dlewis80/DeeplyCastNet/README.md

# DeeplyCastNet
Senior Design Project to make an Underwater Acoustic Modem for swarm robotics

Check out our [wiki](https://github.com/dlewis80/DeeplyCastNet/wiki) for more information!
