dlewis80/DeeplyCastNet/hardware/DeeplyCastNet_BOM.xlsm

Sheet: Instructions
Basic Instructions:
Copy this file to your own computer before filling out forms.
Please keep track of your ticket ID assigned after submission.
***When ordering, submit only ONE ticket/form per vendor.***
 | ONLY fill out ONE tab per ticket.
*Send/Store Acknowledgement upon receipt of order by replying to your ticket email or sending information to megan.horne@gtri.gatech.edu
o Inspect the received items for conformance to purchase requirements and note issues if any
o If you experience issues with procured items or supplier service, such as receipt of damaged or incorrect items, please notify ELSYS Procurement and complete a Nonconforming Procured Item Record.
§ If you experience issues with procured items or supplier service, such as receipt of damaged or incorrect items,
please notify ELSYS Procurement and complete a Nonconforming Procured Item Record under Important Links.
§ After completing the record, please keep a copy in your project files (updating it as needed) and send a copy to QA at ELSYS-ISO-HELP@gtri.gatech.edu.
o Send a record of receipt. Examples of receipt records include:
§ Packing slips
§ Copy of a packing slip with notations
§ E-mail stating confirmation of purchase
§ E-mail stating approval for payment of items
o Store the receipt record in the project files.
Specifics:
-For orders under $10k go to the appropriate tab based on total cost:
 | Orders over $2,499 (including shipping fees) cannot be processed with a vendor who is not in Workday.
 | Orders under $10k can be placed based at your discretion so long as you do market research.
 | A formal quote from the vendor needs to be attached with the ticket.
-Sole Sources are to be used when ONLY 1 vendor can supply the goods or services. For Sole Sources, use the "Sole Source" tab.
 | Orders $10k and over must be sole sourced, soft bid, or open bid.
 | Orders $25k and over must be sole sourced or open bid.
 | A formal quote from the vendor needs to be attached with the ticket.
 | If other vendors can provide the SAME (technically acceptable) item, it is NOT a Sole Source
 | Sole Source orders $25k to under $250k will be posted on the GPR for 5 business days to be challenged.
 | At and above $250k is 15 calendar days.
-Soft Bid is an order between $10k and $25k in which you must obtain a minimum of 3 quotes for specific items or services.
 | Orders $10k and over must be sole sourced, soft bid, or open bid.
 | The quote with the lowest cost (technically acceptable) will be who you order from.
-Open Bid is a full competitive action that must be posted to the Georgia Public Registry for between 3 and 30 calendar days depending on price.
 | Orders $10k and over must be sole sourced, soft bid, or open bid.
 | Orders $25k and over must be sole sourced or open bid.
 | Open Bids can be simple or complicated depending on your requirements.
 | If this is your first Open Bid or if you need help phrasing your requirements, you can contact me or one of our contract officers (Belinda Randolph 404-385 0585)
-Punchouts are pre-established contracts that have no price ceiling.
 | No quote is required for a punchout vendor.
 | Punchout vendors are: BioRad, Dell, Digi-Key, Eurofins, Fisher Scientific, Grainger, HP, ThermoFisher Scientific, MSC, Newark, Sigma-Aldrich, Staples, VWR International, CDW-G, America To Go, Airgas, Amazon and B&H.
 | Punchout orders do not need to have NIGP Code or price fields filled out as they are extraneous.
 | Put punchout orders on the "Under $10K" tab
-If you ever have more than 25 items for one order, submit additional forms on the same ticket. After the first form is completed, you only have to fill out the line item information on subsequent forms.
 | Note: there are two options to "reset" your form. One includes resetting line items only.
Important Links:
Spend Category
NIGP Codes (http://doas.ga.gov/state-purchasing/purchasing-tools/nigp-codes)
Consulting Form - Apex Systems
Consulting Form - Insight Global
Sole Source Form
ELSYS NonConforming Procured Item
Replacement Packing Slip
Disclaimers:
If you fail to fully complete a form, your order will be delayed.
If you fail to submit the form properly (multiple orders on one submitted ticket, missing documents such as a quote or approval), your order will be delayed.
Monetary limits include shipping costs. If you are unsure of the shipping costs, please reach out to the vendor for a shipping estimate.
The brief instructions provided in this spreadsheet are merely rudimentary guidance for completing ELSYS ALL forms and tickets. They are not final or comprehensive and are not intended to be used as or substituted for procurement guidance.
If you have any questions, please contact Megan Horne (404-407-8892)

Sheet: Under $10k
$0.01 - $9,999.99 (1 Vendor Per Ticket) *Send acknowledgement upon receipt of order (see Instructions tab for details) |  |  |  |  |  | Version 6.3
Requestor | Name: | Mick West | Division | TEN | Requestor Comments:
 | Email: | mick.west@gtri.gatech.edu
 | Number (7-1234): | 7-8638
Accounting | M&S Sub-budget (D1234.05.06.07.0008): | W1246.01.00.00.00005
 | Labor Sub-budget (D1234.05.06.07.0008): | W1246.01.00.00.00005
 | Spend Category (123456): | W1246.01.00.00.00005
Vendor | Vendor Name: | Digikey
 | Vendor Website: | digikey.com
Additional Info
 | Please provide a detailed business purpose (including how it will be used on the project). | Material to help with VIP team develop underwater microfloat vehicle.
 | Are these products going to be used exclusively on this project (W1246) as property of the sponsor unless sponsor has authorized us to retain them?
 | Who will be the end user (retain the title) of item(s)/software/services being purchased for ?
 | Is this purchase for hardware, networking, telecom, audio visual or 'X' as a service?
 | Is this purchase an addition to existing inventoried equipment? |  | IF YES: Provide tag # of inventoried equiptment :
 | If this requisition is for an asset, does it require special disposal?
 | Are you currently aware of any additional orders that you intend to place in the forseeable future from this vendor? | No
 | If "Yes", explain and please be specific:
Shipping | Building (list): | 430N 10th ST
 | Room #: | Bay 9
 | Requested shipping method (list):
 | Ship complete or as available (list)(*Note: "complete" - company will hold entire order until backorders are available so this may cause delay*): | As Available
 | Need by date (*Please note if you put a need by date, your shipping method may be updated so that items arrive by this date*):
Line Item | Supplier Part # (not Manufacturer #) | Item Description | Quantity | Unit Price | NIGP Code | OPTIONAL: Link to item at vendor website. Link may be item number/description as hyperlink, or http web address. Supplying links is recommended for Pcard orders to Amazon, eBay and other vendors in addition to supplier and item info.
1 | 2N5401YBUOS-ND | PNP Transistor | 10 | $0.26 | 204--16 | https://www.digikey.com/product-detail/en/on-semiconductor/2N5401YBU/2N5401YBUOS-ND/975298
2 | IR2110PBF-ND | Gate Driver | 5 | $2.92 | 204--16 | https://www.digikey.com/product-detail/en/infineon-technologies/IR2110PBF/IR2110PBF-ND/811566
3 | 296-47192-ND | Linear Regulator | 6 | $1.54 | 204--16 | https://www.digikey.com/product-detail/en/texas-instruments/LM7805CT-NOPB/296-47192-ND/3901929
4 | 296-1845-5-ND | Dual Comparator | 4 | $1.17 |  | https://www.digikey.com/product-detail/en/texas-instruments/TLC372CP/296-1845-5-ND/277490
5 | LMC555CN/NOPB-ND | Timer | 6 | $1.34 |  | https://www.digikey.com/product-detail/en/texas-instruments/LMC555CN-NOPB/LMC555CN-NOPB-ND/32623
6 | IRF540NLPBF-ND | N-Channel MOSFET | 10 | $1.42 |  | https://www.digikey.com/product-detail/en/infineon-technologies/IRF540NLPBF/IRF540NLPBF-ND/812049
7 | PPC1.0KW-2CT-ND | 2W Resistor | 10 | $0.45 |  | https://www.digikey.com/product-detail/en/vishay-bc-components/PR02000201001JR500/PPC1.0KW-2CT-ND/597336
8 | 1740-1198-ND | NPN Transistor | 10 | $0.53 |  | https://www.digikey.com/product-detail/en/ween-semiconductors/PHE13005127/1740-1198-ND/1157518
9 | OP2177CRMZ-ND | Low-Noise Op Amp | 4 | $5.01 |  | https://www.digikey.com/product-detail/en/analog-devices-inc/OP2177CRMZ/OP2177CRMZ-ND/10238174
10 | 296-10230-5-ND | Filter | 6 | $3.89 |  | https://www.digikey.com/product-detail/en/texas-instruments/TLC04ID/296-10230-5-ND/380466
11 | 296-39653-ND | Microcontroller Dev Board | 3 | $20.76 |  | https://www.digikey.com/product-detail/en/texas-instruments/MSP-EXP432P401R/296-39653-ND/5170609
12 | 255-1228-1-ND | Solid State Relay | 3 | $4.04 |  | https://www.digikey.com/product-detail/en/panasonic-electric-works/TQ2SA-3V-Z/255-1228-1-ND/5767573
13 | AD5627RBRMZ-1REEL7CT-ND | DAC | 3 | $6.91 |  | https://www.digikey.com/product-detail/en/analog-devices-inc/AD5627RBRMZ-1REEL7/AD5627RBRMZ-1REEL7CT-ND/4908940
14
15
16
17
18
19
20
21
22
23
24
25
 |  | Total before shipping |  | $201.67

Sheet: Soft Bid
Soft Bid: $10,000 - $24,999.99 (1 Vendor Per Ticket) *Send acknowledgement upon receipt of order (see Instructions tab for details) |  |  |  |  |  | Version 6.3
Requestor | Name: |  | Division |  | Requestor Comments:
 | Email:
 | Number (7-1234):
Accounting | M&S Sub-budget (D1234.05.06.07.0008):
 | Labor Sub-budget (D1234.05.06.07.0008):
 | Spend Category (123456):
Vendor | Winning (lowest bidder) Vendor's Name:
Additional Info
 | Please provide a business purpose. A sentence or two will generally suffice.
 | Are these products going to be used exclusively on this project () as property of the sponsor unless sponsor has authorized us to retain them?
 | Who will be the end user (retain the title) of item(s)/software/services being purchased for ?
 | Is this purchase for hardware, networking, telecom, audio visual or 'X' as a service?
 | Is this purchase an addition to existing inventoried equipment? |  | IF YES: Provide tag # of inventoried equiptment :
 | If this requisition is for an asset, does it require special disposal?
 | Are you currently aware of any additional orders that you intend to place in the forseeable future from this vendor?
 | If "Yes", explain and please be specific:
 | Attach all 3+ bids/quotes
Shipping | Building (list):
 | Room #:
 | Requested shipping method (list):
 | Ship complete or as available (list)(*Note: "complete" - company will hold entire order until backorders are available so this may cause delay*):
 | Need by date (*Please note if you put a need by date, your shipping method may be updated so that items arrive by this date*):
Line Item | Supplier Part # (not Manufacturer #) | Item Description | Quantity | Unit Price | NIGP Code | OPTIONAL: Link to item at vendor website. Link may be item number/description as hyperlink, or http web address. Supplying links is recommended for Pcard orders to Amazon, eBay and other vendors in addition to supplier and item info.
1
2
3
4
5
6
7
8
9
10
11
12
13
14
15
16
17
18
19
20
21
22
23
24
25
 |  | Total before shipping |  | $0.00

Sheet: Open Bid
Open Bid: $25,000 and Over *Send acknowledgement upon receipt of order (see Instructions tab for details) |  |  |  | Version 6.3
Requestor | Name: | Division | Requestor Comments:
 | Email:
 | Number (7-1234):
Accounting | M&S Sub-budget (D1234.05.06.07.0008):
 | Labor Sub-budget (D1234.05.06.07.0008):
 | Spend Category (123456):
Vendor | Preferred Vendor List Include as much relevant contact information as you can, particularly: name/address/email/phone#
Additional Info
 | Expected delivery/start date:
 | Will you accept "or GIT accepted equal"?
 | What is the estimated amount of the purchase?
 | NIGP Code
 | Are these products going to be used exclusively on this project () as property of the sponsor unless sponsor has authorized us to retain them?
 | Who will be the end user (retain the title) of item(s)/software/services being purchased for ?
 | Is this purchase for hardware, networking, telecom, audio visual or 'X' as a service?
 | Is this purchase an addition to existing inventoried equipment? | IF YES: Provide tag # of inventoried equiptment :
 | If this requisition is for an asset, does it require special disposal?
 | Are you currently aware of any additional orders that you intend to place in the forseeable future from this vendor?
 | Attach Requirements
Shipping | Building (list):
 | Room #:
 | Requested shipping method (list):
 | Ship complete or as available (list)(*Note: "complete" - company will hold entire order until backorders are available so this may cause delay*):

Sheet: Sole Source
Sole Source: $10,000 and over (1 Vendor Per Ticket) *Send acknowledgement upon receipt of order (see Instructions tab for details) |  |  |  |  |  | Version 6.3
Requestor | Name: |  | Division |  | Requestor Comments:
 | Email:
 | Number (7-1234):
Accounting | M&S Sub-budget (D1234.05.06.07.0008):
 | Labor Sub-budget (D1234.05.06.07.0008):
 | Spend Category (123456):
 | Are these products going to be used exclusively on this project () as property of the sponsor unless sponsor has authorized us to retain them?
 | Who will be the end user (retain the title) of item(s)/software/services being purchased for ?
 | Is this purchase for hardware, networking, telecom, audio visual or 'X' as a service?
 | Is this purchase an addition to existing inventoried equipment? |  | IF YES: Provide tag # of inventoried equiptment :
 | If this requisition is for an asset, does it require special disposal?
 | Are you currently aware of any additional orders that you intend to place in the forseeable future from this vendor?
External Requirement | Fill out the below .pdf form:
 | Sole Source Form
 | Vendor Name:
Additional Info : | On the above form: *Contact Name* is the name of the Engineer who is qualified to answer technical questions about the item(s). *Requisition #* can be left blank.
Shipping | Building (list):
 | Room #:
 | Requested shipping method (list):
 | Ship complete or as available (list)(*Note: "complete" - company will hold entire order until backorders are available so this may cause delay*):
 | Need by date (*Please note if you put a need by date, your shipping method may be updated so that items arrive by this date*):
Line Item | Supplier Part # (not Manufacturer #) | Item Description | Quantity | Unit Price | NIGP Code | OPTIONAL: Link to item at vendor website. Link may be item number/description as hyperlink, or http web address. Supplying links is recommended for Pcard orders to Amazon, eBay and other vendors in addition to supplier and item info.
1
2
3
4
5
6
7
8
9
10
11
12
13
14
15
16
17
18
19
20
21
22
23
24
25
 |  | Total before shipping |  | $0.00

Sheet: Contractor
Contractor (1 Contractor Per Ticket) *Ensure that you are following updated processes with HR prior to submitting this request for a PO |  |  |  |  | Version 6.3
Requestor | Name: |  | Division | Requestor Comments:
 | Email:
 | Number (7-1234):
Accounting | Labor Sub-budget (D1234.05.06.07.0008):
 | Contractor's Manager:
 | Who is tracking their hours?
 | Will this contractor be working on sponsored SOW?
Forms | Attach Contractor's Resume
 | Attach Consulting Form
 | Attach Work Order
 | Attach FAR
 | Attach NDA
Line Item | Contractor's Name | Start Date - End Date | Total Price
1
 |  | Total | $0.00

Sheet: Database
 | Ticket # (For Pcard orders, vendor uses Ticket # as PO#) | Project Number / Account Code | Charge Number for Time | Vendor (Supplier) | Ordered: WorkDay / Email / Fax / Online / Phone / Store | Date Ordered | WorkDay RQ# / WorkDay PO# / Vendor Order#(s) / How Ship or Delivery Date / Tracking# | Invoice Amount | Division | Street/ RM/ Ext. | Ordered For | Additional Information
Under 10k |  | W1246.01.00.00.00005/W1246.01.00.00.00005 | W1246.01.00.00.00005 | Digikey |  |  | /PO- // | 201.67 | TEN | 430N 10th ST/Bay 9/7-8638 | Mick West
Soft Bid |  | / | .... | 0 |  |  | /PO- /// | 0.00 | 0 | // | 0
Open Bid |  | / | .... |  |  |  | /PO- /// | 0.00 | 0 | // | 0
Sole Source |  | / | .... | 0 |  |  | /PO- /// | 0.00 | 0 | // | 0
Contractor |  | / 751110 | .... | Apex / Insight Global |  |  | /PO- | 0.00 | 0 |  | /
