dlewis80/DeeplyCastNet/(list of files, cad)

Other CAD files:
uCtrl/cmsis_dsplib_vibration_msp432p401r_MSP_EXP432P401R_nortos_ccs/Debug/ccs/startup_msp432p401r_ccs.obj
