dlewis80/DeeplyCastNet/hardware/rev1_header_done.brd

## EAGLE design hardware/rev1_header_done.brd (2020-04-30)

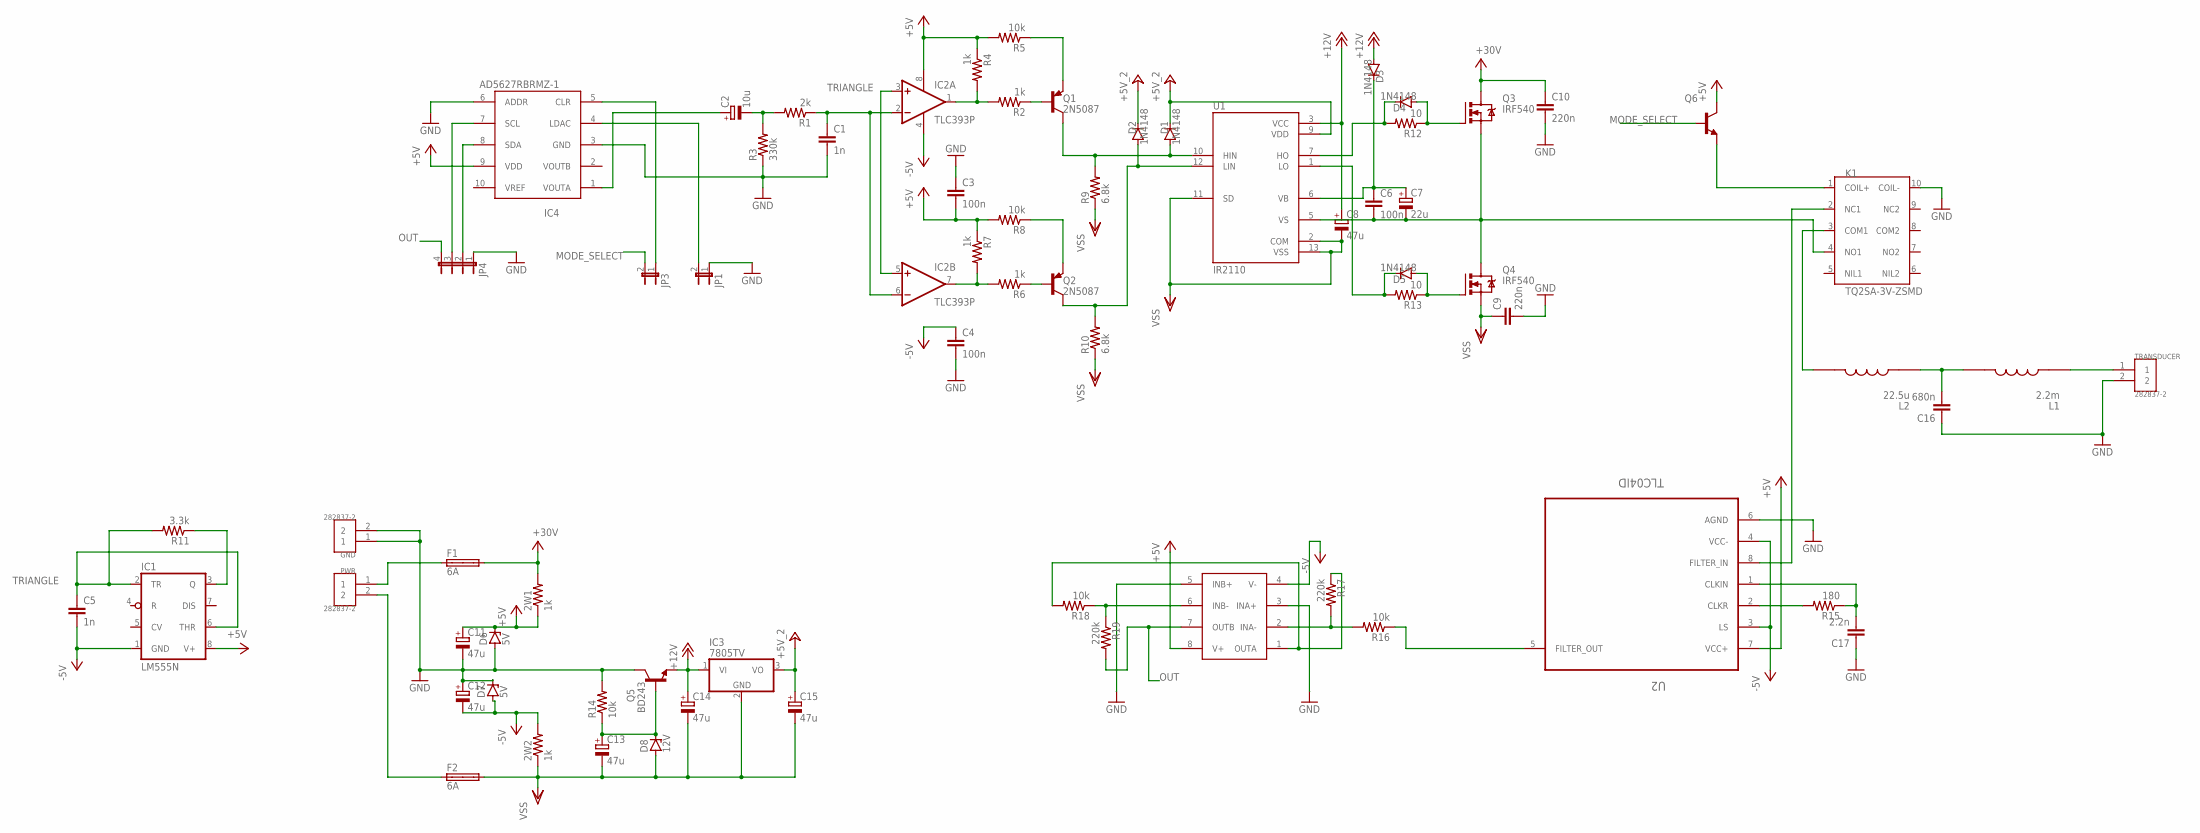
[picture p8: schematic rev1_header_done.sch]

Parts:
2W1, 2W2: 1k; V235/17
C1, C5: 1n; C050-025X075
C2: 10u; E2,5-6E
C3, C4, C6: 100n; C050-025X075
C7: 22u; E2,5-6E
C8, C11, C12, C13, C14, C15: 47u; E2,5-6E
C9, C10: 220n; C050-025X075
C16: 680n; C050-025X075
C17: 2.2n; C050-025X075
D1, D2, D3, D4, D5: 1N4148; DO35-7
D6, D7: 5V; DO41Z10
D8: 12V; DO41Z10
F1, F2: 6A; SHK20L
GND: 282837-2; TE_282837-2
IC1: LM555N; DIL08
IC2: TLC393P; DIL08
IC3: 7805TV; TO220V
IC4: AD5627RBRMZ-1; SOP50P490X110-10N
IC5: OP2177CRMZ; SOP65P490X110-8N
JP1, JP3: JP1E; JP1
JP4: JP4E; JP4
K1: TQ2SA-3V-ZSMD; TQ2SA-3V-Z
L1: 2.2m; IND_LQH43NN222K03L
L2: 22.5u; IND_LQH43NN222K03L
PWR: 282837-2; TE_282837-2
Q1, Q2: 2N5087; TO92
Q3, Q4: IRF540; TO220BV
Q5: BD243; TO220
Q6: -NPN-TO92; TO92
R1: 2k; V234/12
R2, R4, R6, R7: 1k; V234/12
R3: 330k; V234/12
R5, R8, R14, R16, R18: 10k; V234/12
R9, R10: 6.8k; V234/12
R11: 3.3k; V234/12
R12, R13: 10; V234/12
R15: 180; V234/12
R17, R19: 220k; V234/12
TRANSDUCER: 282837-2; TE_282837-2
U1: IR2110; DIP762W45P254L2019H533Q14
U2: TLC04ID; SOIC127P600X175-8N

Connections:
+5V: 2W1.1, C3.2, C11.+, D6.C, IC1.8 (V+), IC2.8 (V+), IC4.9 (VDD), IC5.8 (V+), Q6.3 (C), R4.1, R5.2, R7.1, R8.2, U2.7 (VCC+)
+5V_2: C15.+, D1.C, D2.C, IC3.3 (VO), U1.9 (VDD)
+12V: C8.+, C14.+, D3.A, IC3.1 (VI), Q5.3 (E), U1.3 (VCC)
-5V: 2W2.2, C4.1, C5.2, C12.-, D7.A, IC1.1 (GND), IC2.4 (V-), IC5.4 (V-), U2.3 (LS), U2.4 (VCC-)
CLR: IC4.5 (CLR), JP3.1
GND: C1.2, C3.1, C4.2, C9.2, C10.2, C11.-, C12.+, C16.1, C17.1, D6.A, D7.C, GND.1, GND.2, IC4.3 (GND), IC4.6 (ADDR), IC5.3 (INA+), IC5.5 (INB+), JP1.1, JP4.1, K1.10 (COIL-), Q5.2 (C), R3.1, R14.2, TRANSDUCER.2, U2.6 (AGND)
H_GATE: D4.A, Q3.G, R12.1
LDAC: IC4.4 (LDAC), JP1.2
L_GATE: D5.A, Q4.G, R13.1
MODE_SELECT: JP3.2, Q6.2 (B)
unnamed: C2.+, IC4.1 (VOUTA)
unnamed: C2.-, R1.2, R3.2
unnamed: C1.1, IC2.2 (-IN), IC2.6 (-IN), R1.1
unnamed: IC2.1 (OUT), R2.2, R4.2
unnamed: Q1.2 (B), R2.1
unnamed: Q1.3 (E), R5.1
unnamed: IC2.7 (OUT), R6.2, R7.2
unnamed: Q2.3 (E), R8.1
unnamed: Q2.2 (B), R6.1
unnamed: D1.A, Q1.1 (C), R9.2, U1.10 (HIN)
unnamed: D2.A, Q2.1 (C), R10.2, U1.12 (LIN)
unnamed: IC1.3 (Q), R11.1
unnamed: C6.1, C7.+, D3.C, U1.6 (VB)
unnamed: C16.2, L1.2, L2.1
unnamed: D4.C, R12.2, U1.7 (HO)
unnamed: D5.C, R13.2, U1.1 (LO)
unnamed: K1.3 (COM1), L2.2
unnamed: K1.1 (COIL+), Q6.1 (E)
unnamed: L1.1, TRANSDUCER.1
unnamed: F1.1A, PWR.1
unnamed: F2.1A, PWR.2
unnamed: C13.+, D8.C, Q5.1 (B), R14.1
unnamed: K1.2 (NC1), U2.8 (FILTER_IN)
unnamed: R15.2, U2.2 (CLKR)
unnamed: C17.2, R15.1, U2.1 (CLKIN)
unnamed: R16.1, U2.5 (FILTER_OUT)
unnamed: IC5.2 (INA-), R16.2, R17.2
unnamed: IC5.1 (OUTA), R17.1, R18.2
unnamed: IC5.6 (INB-), R18.1, R19.1
OUT: IC5.7 (OUTB), JP4.4, R19.2
SCL: IC4.7 (SCL), JP4.3
SDA: IC4.8 (SDA), JP4.2
TRANSMIT: C6.2, C7.-, K1.4 (NO1), Q3.S, Q4.D, U1.5 (VS)
TRIANGLE: C5.1, IC1.2 (TR), IC1.6 (THR), IC2.3 (+IN), IC2.5 (+IN), R11.2
V+: 2W1.2, C10.1, F1.2A, Q3.D
VSS: 2W2.1, C8.-, C9.1, C13.-, C14.-, C15.-, D8.A, F2.2A, IC3.2 (GND), Q4.S, R9.1, R10.1, U1.2 (COM), U1.11 (SD), U1.13 (VSS)

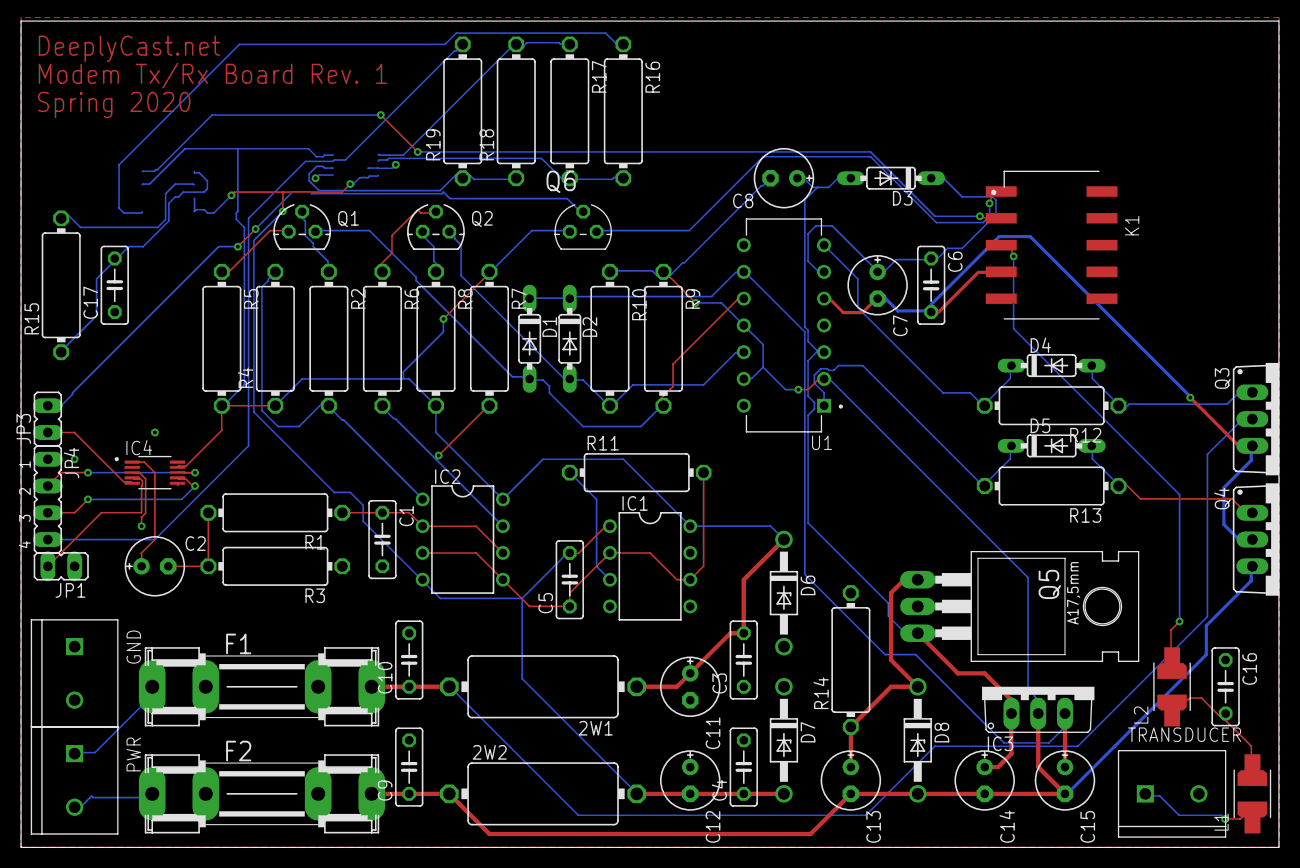
[picture p9: board rev1_header_done.brd from above]

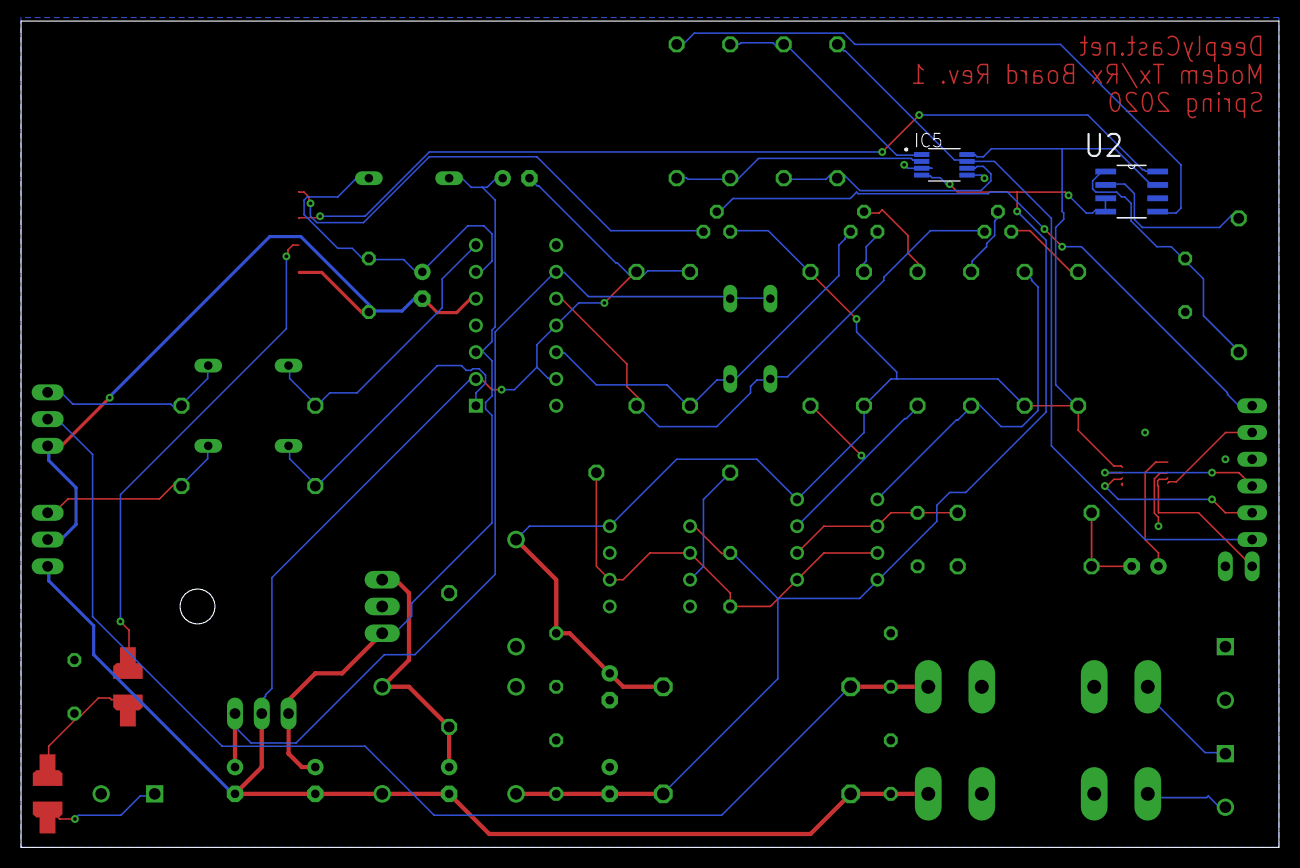
[picture p10: board rev1_header_done.brd from below]

Board: 2 copper layers, 119.4 x 78.4 mm, 70 parts (2 on the bottom side), 46 nets.
