dlewis80/DeeplyCastNet/(commit log)

2020-03-05 base code with verfied 100 khz sampling
    [startup_msp432p401r_ccs.obj]
2020-03-14 Removed old Project
    [startup_msp432p401r_ccs.obj]
2020-03-14 New project with 100 Khz sampling
    [startup_msp432p401r_ccs.obj]
2020-04-26 very messy prototype with transmit and receive
2020-04-27 new relay gpio
2020-04-30 Uploaded EAGLE Files
    [rev1_header_done.brd, rev1_header_done.sch]
